dev1adesh/CapstoneGroup52/docs/FinalReport/MTE 481 - FDP (Actual).pdf

# MTE 481 -FINAL DESIGN

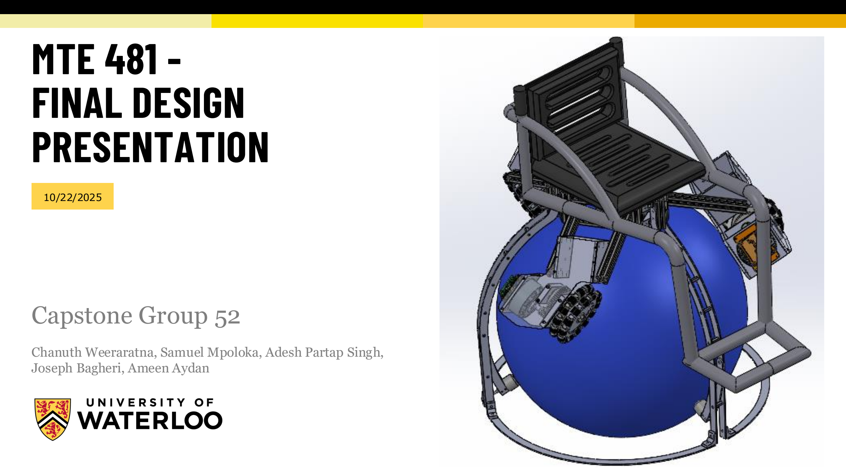
[picture p17: page 1]

# PRESENTATION

Photo credit: @bruce.digital

## Capstone Group 52

Chanuth Weeraratna, Samuel Mpoloka, Adesh Partap Singh, Joseph Bagheri, Ameen Aydan

10/22/2025

# REFRESH - NEEDS IDENTIFICATION

Factually:

- Wheelchair users engaged in day-to-day tasks are fundamentally limited by the need to use their hands for both propulsion and steering. → Hand accessibility
- “Building up through repetition” loads the shoulders in ways it was never optimized to bear over years. ( (https://pmc.ncbi.nlm.nih.gov/articles/PMC7364791/?utm_source=chatgpt.com)Barry Mason, (https://pmc.ncbi.nlm.nih.gov/articles/PMC7364791) 2020) (https://pmc.ncbi.nlm.nih.gov/articles/PMC7364791/?utm_source=chatgpt.com) → Prevalence of injury
- Those playing sports more than 1×/week had 75.7% occurrence of rotator cuff tears, vs. 36.3% in non-sport users. (Michael Akbar, 2015) (https://pmc.ncbi.nlm.nih.gov/articles/PMC5697842/) → Major barrier to participation

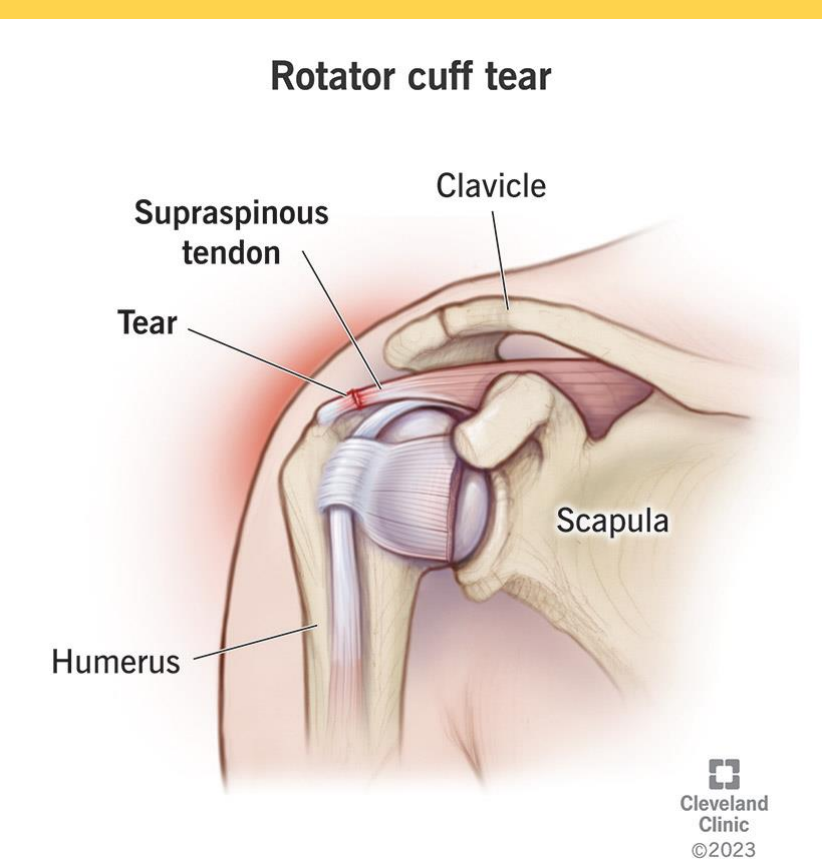
[picture p18: figure]

MTE 481 - FINAL DESIGN PRESENTATION | PAGE 2

Anecdotally:

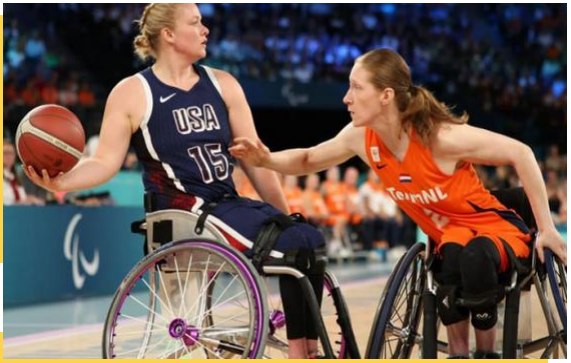
[picture p19: figure]

- Adrit Batra from Laurier enjoys street hockey as a hobby but finds that his arms frequently fatigue and the difficulty of single handed manipulation creates a steep learning curve.
- UWaterloo baseball operations coordinator Brody Daigneau finds that physical limitations not only affect performance, but also discourage play with non-impaired individuals, widening the inclusion gap.

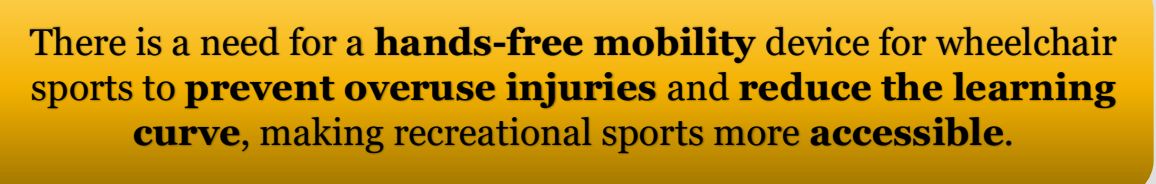
[picture p20: figure]

## There is a need for a hands-free mobility device for wheelchair sports to prevent overuse injuries and reduce the learning

curve, making recreational sports more accessible.

# NEEDS STATEMENT

# PROBLEM DEFINITION

- Hands-free propelling and steering while handling objects during gameplay.
- Working with the CAPACITY initiative to bring this hands-free wheelchair to PAC where it can be used for drop-in gameplay on campus.
- Focused on use in basketball to limit variables in design.
Object of Interaction | Environment
- Standard basketball • 50th to 90th percentile anthropometric human | • Basketball court • Flat, level, smooth surface • Good friction coefficient

Vague, non-measurable requirements

- Operation is simple and intuitive
- Including user control sensitivity adjustment
- Wheelchair is safe for the user and those around them
- Failsafe measures
- Speed limiter
- Passive and/or active protection from collisions
- Emergency stop

# USER REQUIREMENTS

- Human-machine interface doesn’t require input from the hands or arms
- Operation doesn’t interfere with gameplay
- E.g. the user takes their eyes off the ball
- Control accounts for a varying range of disabilities
- Cannot accommodate limited trunk control (class 1.0 -2.0 level disability).

# Engineering Requirements – Criteria Table

# | Criterion | Constraint | Objective

1 | Weight Capacity | 80kg | 110kg
2 | Footprint Radius | 60cm | 40cm
3 | Max Linear Speed (in all directions) | 2.3 m/s | 4.5 m/s
3 | Max Linear Acceleration (in all directions) | m 0.7 2 s | m 1.3 2 s
4 | Turning Time | - | 180 degrees in 1 sec
5 | Seat Height (Footrest to seat) | 50 ± 10cm | -
6 | Total Operating Time | 12mins | 40mins

# Critical Geometry

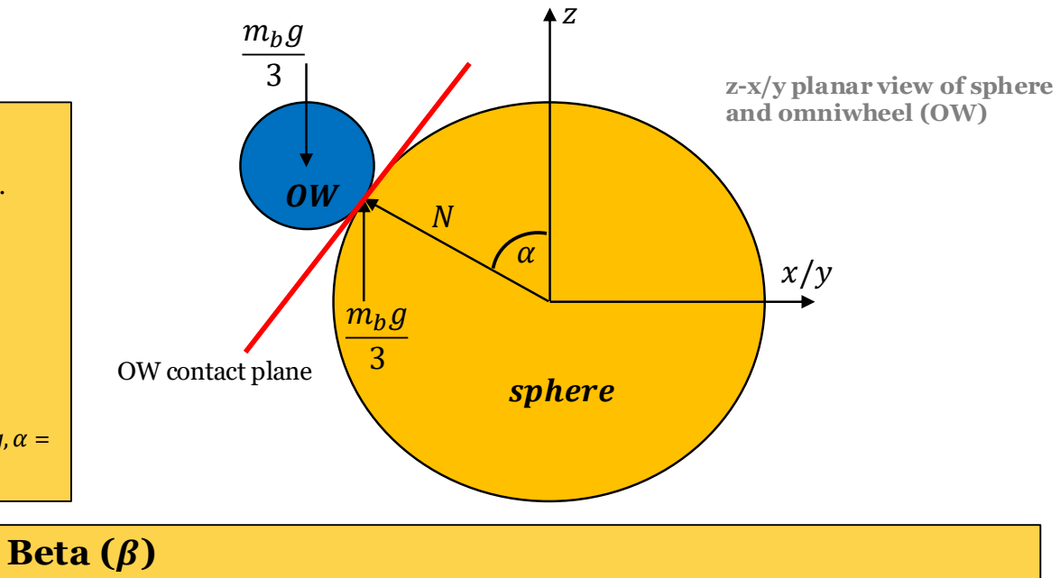
[picture p21: figure]
Beta (β); mbg 3; sphere; z-x/y planar view of sphere and omniwheel (OW); OW contact plane
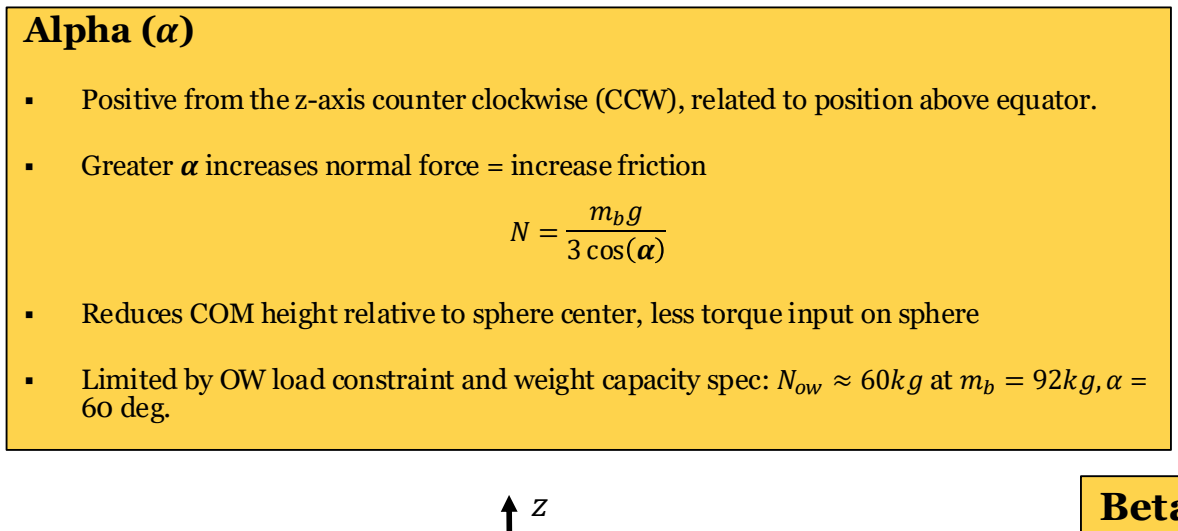
[picture p22: figure]
Alpha (α); mbg 3 cos α; 60 deg.

- Positive from the z-axis counter clockwise (CCW), related to position above equator.
- Greater α increases normal force = increase friction
- Reduces COM height relative to sphere center, less torque input on sphere
- Limited by OW load constraint and weight capacity spec: Now ≈ 60kg at mb = 92kg, α =

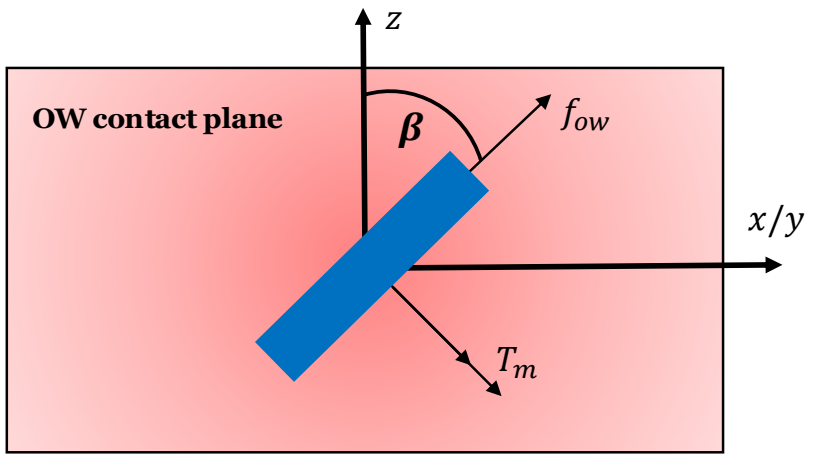
[picture p23: figure]
fow; OW contact plane

- β = 0° gives best x-y translation (resultant sits in friction cone), but can’t rotate platform body.
- At α = 60° → β ≈ 42° so OW are in mutually orthogonal planes. Most efficient orientation because no backdriving
- Set β = 30° to satisfy turning time (Tz
) and translation spec
(Tx, Ty) while maximizing efficiency.

# Transmission Specifications

Wheel Torque and Speed Modelling

- Wheeled inverse pendulum model taken in the z-x and z-y planes, linearized about sphere centre (θb ≥ 15 °).
- Ode45() function MATLAB to find inverse dynamics with eqn (1) and (2) (desired motion → torque at sphere centre along certain plane)
- Sphere acceleration, velocity and direction mapped to torque, angular velocity components in sphere centre, mapped to torque and speed requirements at wheel, eqn
(3) and (4). Note: Tw is transposed for wheel speed conversion matrix.
- Turning time is simple torque about z, Tz and inertia of body about z (relatively low requirements, beta didn’t need to be extreme)
| Ts Mxሷ+ mblθሷ= (1) rs

2 θሷ− mblxሷ= Ts(2) mbglθ − Ib + mbl

Motor Spec

- Max wheel torque and speed extracted for linear acceleration, linear velocity and turning speed specs.
- Cont. and within linear T-w region → 1:4 speed red.
| Speed (rad/s) | Torque(N. m.)
OW requirement | 55 | 13
M8325s 100KV | 218 | 3.3

z-axis

x/y-axis

# Mechanical Design

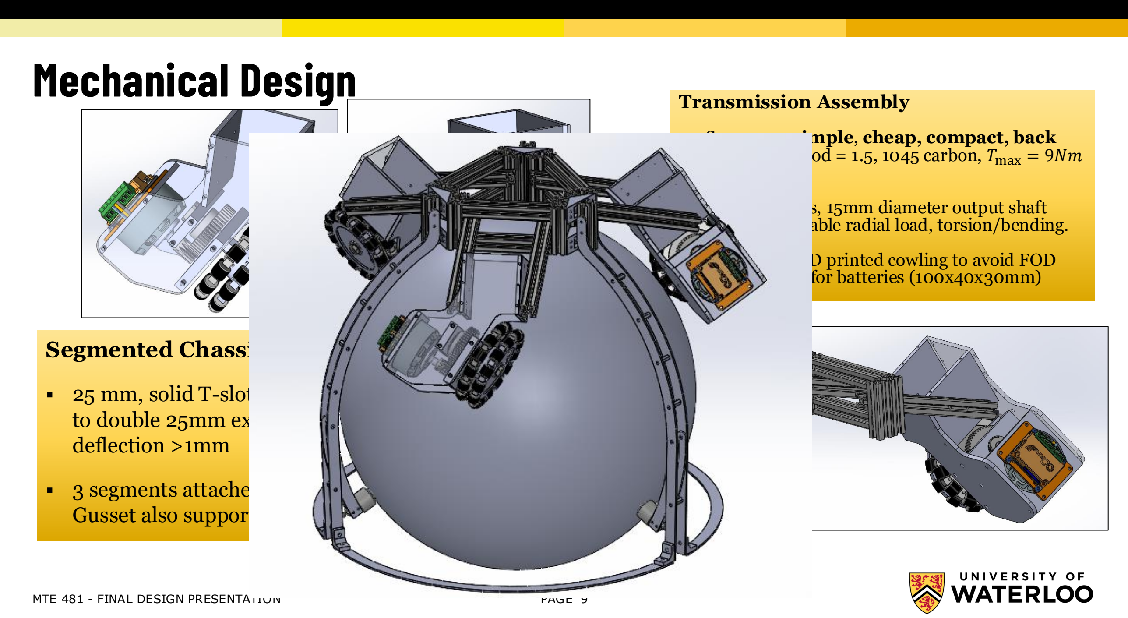
[picture p24: page 9]

Transmission Assembly

- Spur gears simple, cheap, compact, back drivable. (mod = 1.5, 1045 carbon, Tmax = 9Nm at pinion)
- 6202 bearings, 15mm diameter output shaft within acceptable radial load, torsion/bending.
- Sealed with 3D printed cowling to avoid FOD and add area for batteries (100x40x30mm)

Segmented Chassis

- 25 mm, solid T-slot extrusion cantilever to double 25mm extrusion. Expected deflection >1mm
- 3 segments attached via thick AL gusset. Gusset also support safety hardware.

# Mechanical Design

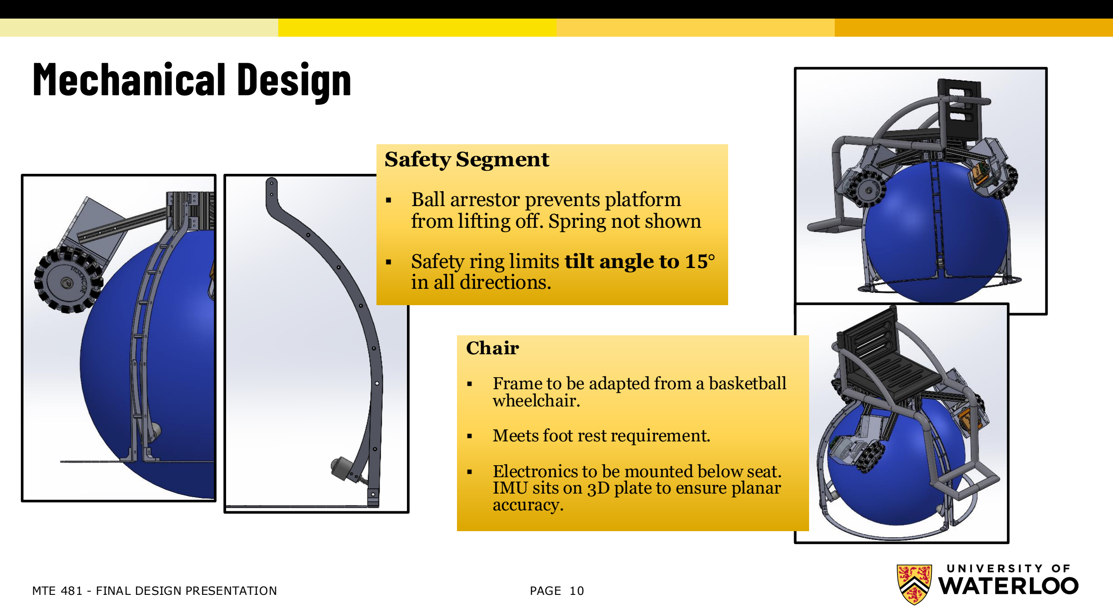
[picture p25: page 10]

Chair

- Frame to be adapted from a basketball wheelchair.
- Meets foot rest requirement.
- Electronics to be mounted below seat. IMU sits on 3D plate to ensure planar accuracy.

Safety Segment

- Ball arrestor prevents platform from lifting off. Spring not shown
- Safety ring limits tilt angle to 15° in all directions.

# Mechanical Design

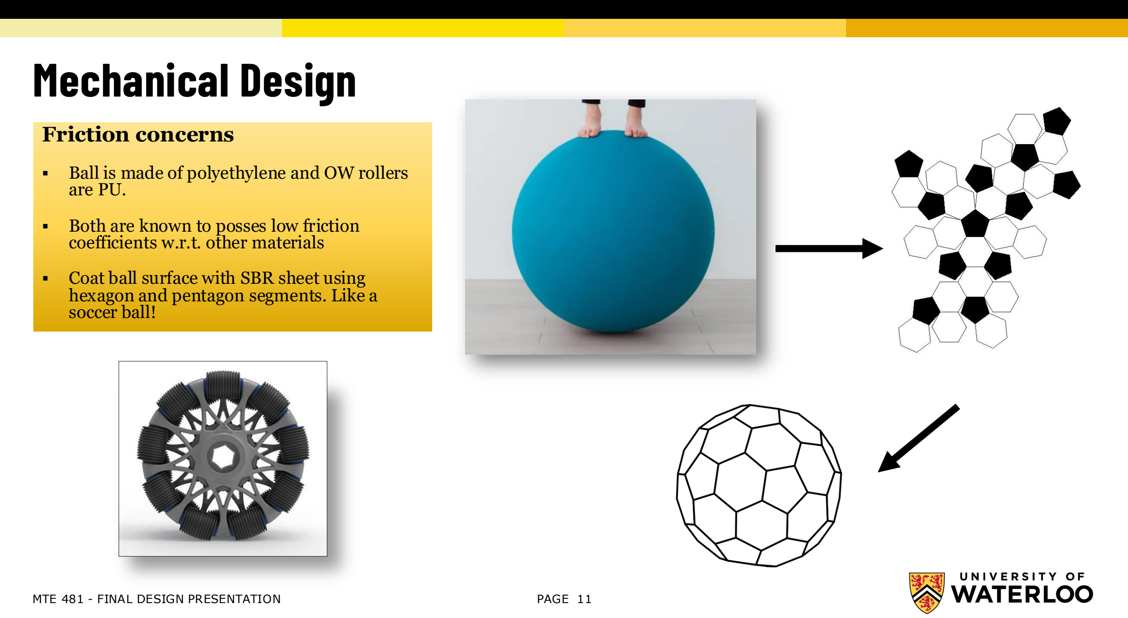
[picture p26: page 11]

Friction concerns

- Ball is made of polyethylene and OW rollers are PU.
- Both are known to posses low friction coefficients w.r.t. other materials
- Coat ball surface with SBR sheet using hexagon and pentagon segments. Like a soccer ball!

# Electrical System

Subsystem | Parts Included | Function
Power System | Batteries, Fuses, Relays, Volt/Ammeter, E-Stop | High-current power + safety
Motor Control | ODrive S1, M8325 Motors, Encoders | High-current power + safety
CAN Network | Transceiver, Bus Wiring, Termination | Communication backbone
MCU | Teensy 4.1 + Power | Central controller for LQR + system logic
IMU | BNO086 Sensors | User-lean + state estimation

# High-Level Block Diagram

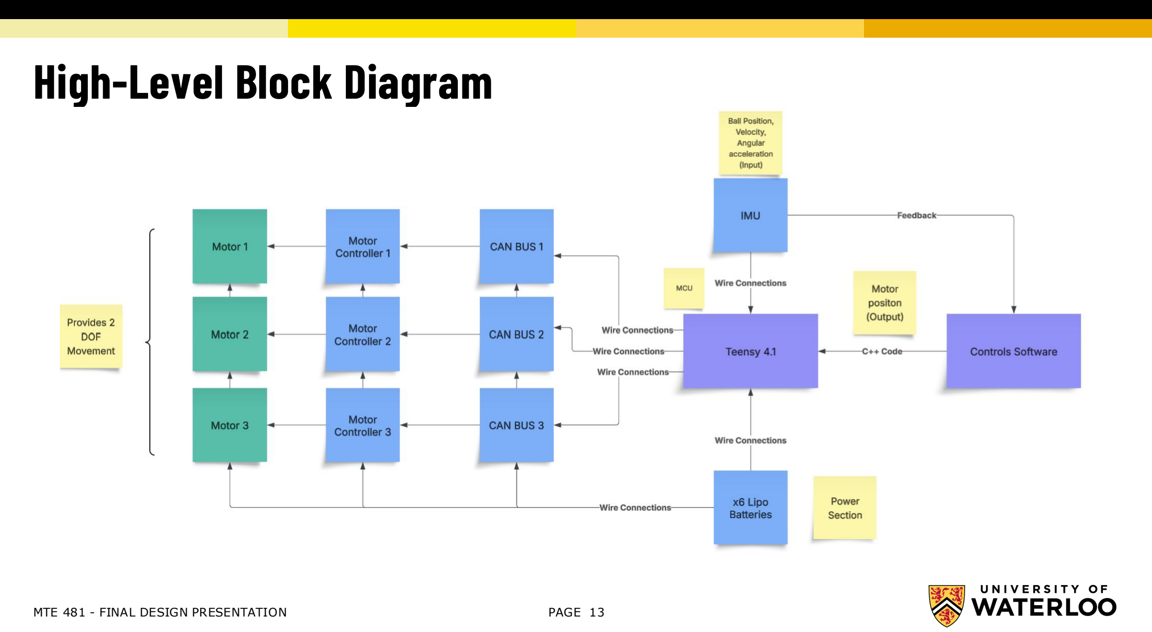
[picture p27: page 13]

# System Architecture

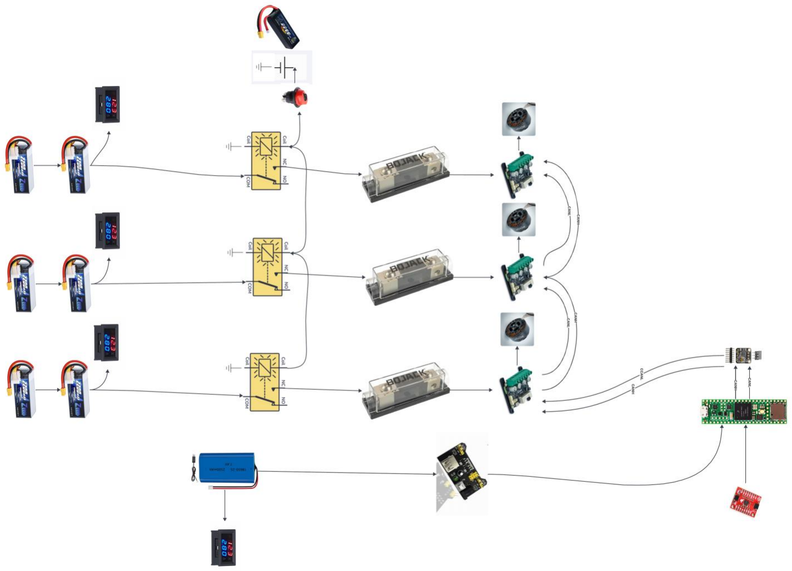
[picture p28: figure]

Electrical System Design Choices

- LiPo batteries arranged in 2-in-series pairs
- Safety System: Relay, Precharge circuitry, fuses, Estop
- Sensor Redundancy

# Operating Time

Given:

- Kt = 0.083 Nm
A
- τmax = 3.3 Nm
- ωmax = 2A = 2π × 30 = 188.5

rad
s
- Rpℎase = 0.024 Ω
- ηmotor = 85 %
- Vbatt pack44.4V
- C = 2.2 Aℎ

I =

τmax
Kt

= 39.8 A ≅ 40 A

Pmecℎ = τmax × ωmax = 622 W

## Pcu = I

## 2 × R = 40² × 0.024 = 38 W

Ptotal = Pmecℎ + Pcu = 660 W ηmotor = Ptotal/Pin
Pin= Ptotal /ηmotor=660/0.85=776 W

Vbatt pack = 44.4V

## C = 2.2 Aℎ E = Vbatt pack × C = 44.4 × 2.2 = 98 Wℎ

## t = E/ Pin = 98/776 = 0.126 h

## t =0.126 × 60 = 7.56 mins

Power Calculations

Operating Time

# Wiring

- Logic Power: The Teensy microcontroller supplies 3.3V and GND to power the CAN transceiver module.

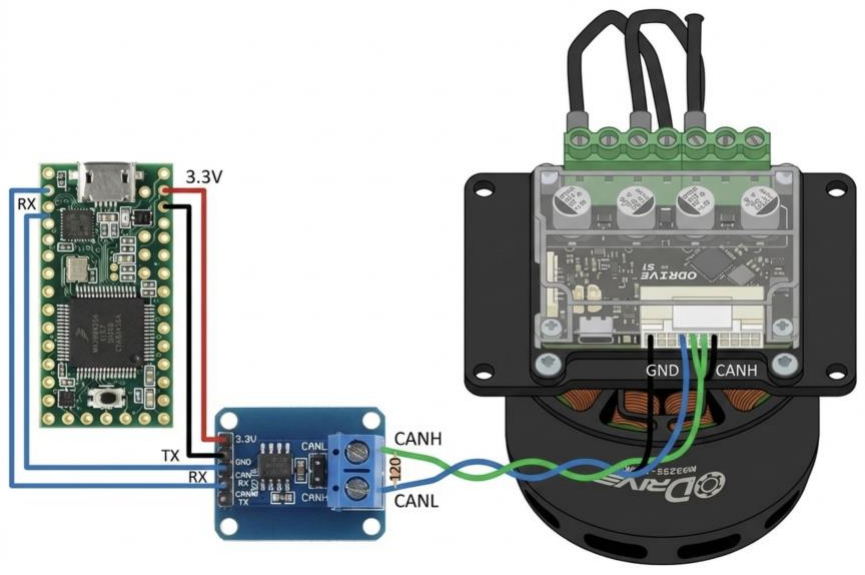
[picture p29: figure]

- Signal Interface: Teensy TX/RX pins transmit single-ended UART commands to the transceiver chip.
- Protocol Conversion: The transceiver converts these logic signals into Differential CAN (CAN High & CAN Low) for robust data transmission.
- Controller Input: The differential CAN lines connect directly to the ODrive S1's dedicated communication port.
- Hardware Integration: The ODrive S1 is mounted directly to the motor backplate, eliminating the need for external phase wiring.

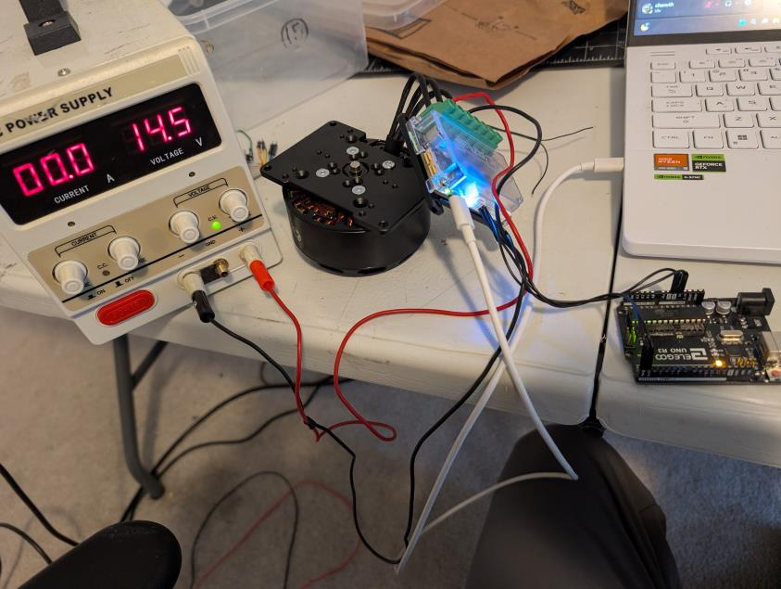
[picture p30: figure]

# Testing

- Hardware Integration: Successfully integrated the M8325 Brushless DC motor with the ODrive Pro motor controller for high-precision actuation.
- Communication Protocol: Established a UART serial interface between the Arduino microcontroller and ODrive for real-time command transmission.
- Configuration: Calibrated motor parameters (current limits and velocity gains) using the ODrive GUI prior to embedded deployment.

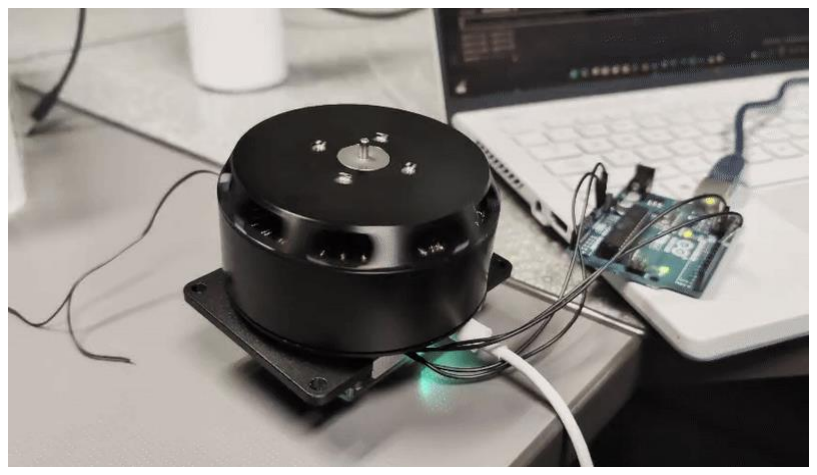
[picture p31: figure]

- Power Verification: Validated system performance under load using a 14.5V lab bench power supply configuration.
- Functional Testing: Confirmed successful motor states (Idle, Closed-Loop Control) and position targeting via Arduino commands.

# Next steps for Electrical setup

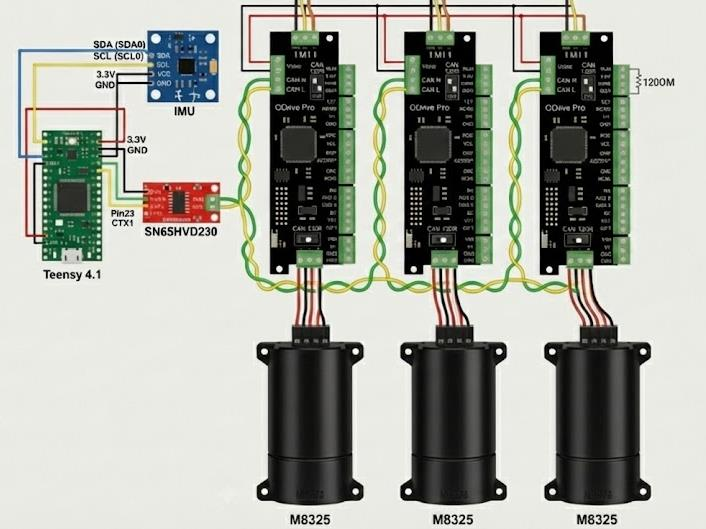
[picture p32: figure]

- Architecture Migration: Transition from UART to
CAN Bus communication to enable robust, high-speed daisy-chaining of three independent ODrive motor nodes.
- Processor Upgrade: Replace the Arduino with a Teensy 4.1 to leverage its native CAN support and higher processing speed for low-latency multi-axis coordination.
- State Estimation: Integrate a 6-DOF IMU (via I2C/SPI) to provide real-time orientation feedback and system state data to the main controller.
- Control Logic: Implement a closed-loop PID algorithm on the Teensy that maps IMU orientation error to counter-active torque commands for dynamic stabilization.
- System Scaling: Scale the electrical subsystem to support simultaneous current draw for all three M8325 motors while maintaining signal integrity.

# Controls Design

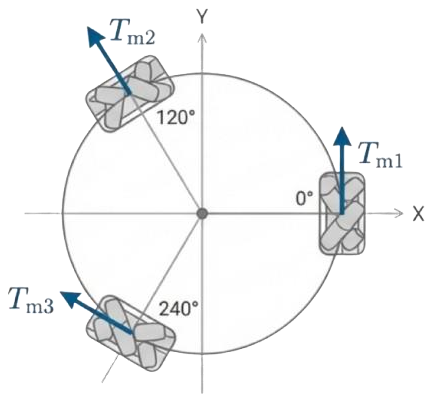
[picture p33: figure]

## Goal:

- Achieve intuitive, real-time control based on the user's lean, mirroring the seamless motion of а Segway.

## The Core Problem:

- Achieve intuitive, real-time control based on the user's lean, mirroring the seamless motion of а Segway.

# From Physics to Formulas: Modeling Our System Plant

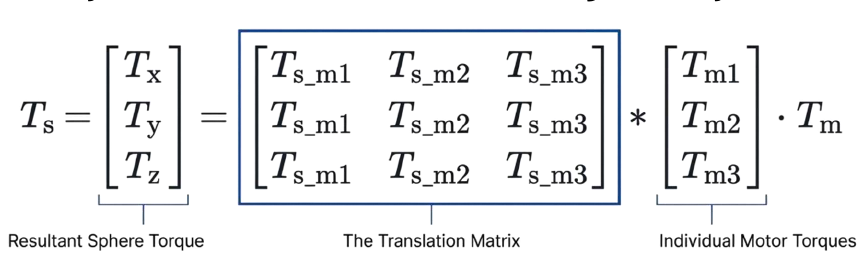
[picture p34: figure]

- This matrix translates individual motor torques into a net torque on the sphere, forming the core of our dynamic model.
- A precise model is essential for designing a controller that performs predictably.
- We translated the system's physics into a
state-space representation using
MATLAB.
Key Assumptions: - 100% motor efficiency. - No-slip contact between omni-wheels and sphere.

# State-Space Controller for Optimal Performance

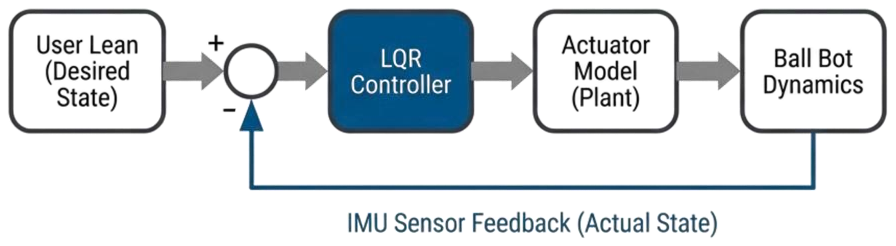
[picture p35: figure]

- Tunable Performance: Allows us to precisely tune the trade-off between aggressive responsiveness and smooth energy consumption.
- Guaranteed Stability: Provides a mathematically proven guarantee of stability for our linearized model.

Chosen Method: A Linear-Quadratic Regulator (LQR) state-space approach. Why LQR?

- Optimal for MIMO Systems: Ideally suited for managing multiple inputs (motor torques) and outputs (position, orientation).

Refine the Controller in a Realistic Virtual World.

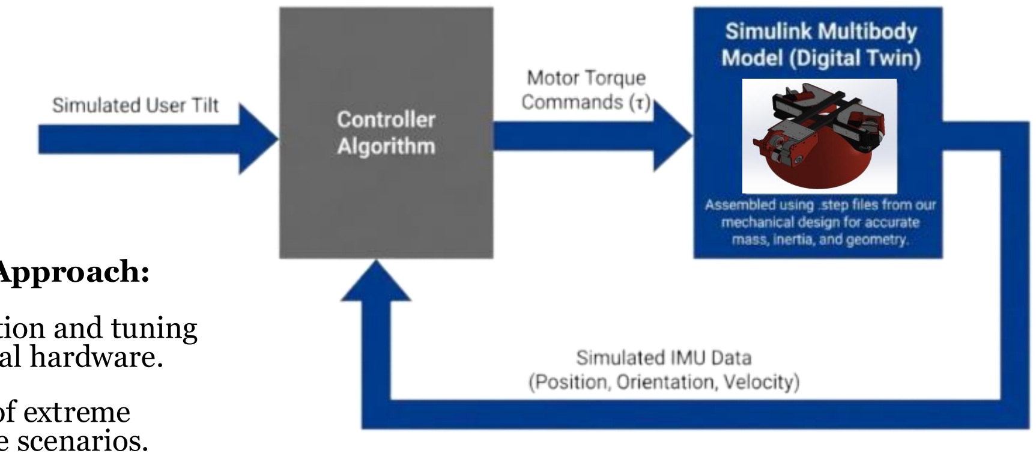
[picture p36: figure]

Key Benefits of This Approach:

- Allows for rapid iteration and tuning without risk to physical hardware.
- Enables safe testing of extreme maneuvers and failure scenarios.
- Ensures the controller is robust and reliable before physical deployment.
