dev1adesh/CapstoneGroup52/docs/FinalReport/MTE481 - Preliminary Design Presentation.pdf

# MTE 481 -PRELIMINARY DESIGN

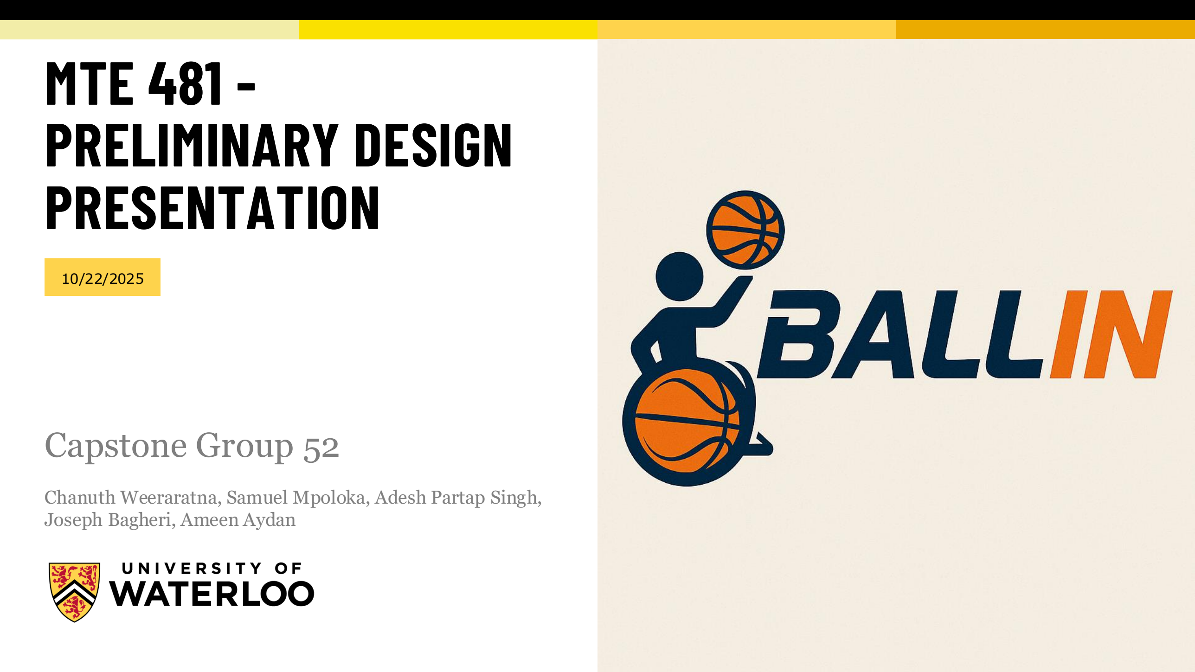
[picture p37: page 1]

# PRESENTATION

Photo credit: @bruce.digital

# Capstone Group 52

Chanuth Weeraratna, Samuel Mpoloka, Adesh Partap Singh, Joseph Bagheri, Ameen Aydan

10/22/2025

## I. Needs Identification

## II. Problem Definition

## III. Design Specification (Criterion, Constraints, Objectives)

## IV. Alternate Design Concepts

## V. Selection Matrix

## VI. Applicable Patent

## VII. Timeline (Gantt chart)

MTE 481 - PRELIMINARY DESIGN PRESENTATION | PAGE 2

# PRESENTATION CONTENT

# Hands Free Mobility

# NEEDS IDENTIFICATION

# NEEDS IDENTIFICATION

- Wheelchair users engaged in day-to-day tasks are fundamentally limited by the need to use their hands for both propulsion and steering.
- What activities could always be more enjoyable or easier with access to both hands?
- E.g. Holding your kids' hands, opening a door, carrying groceries, etc

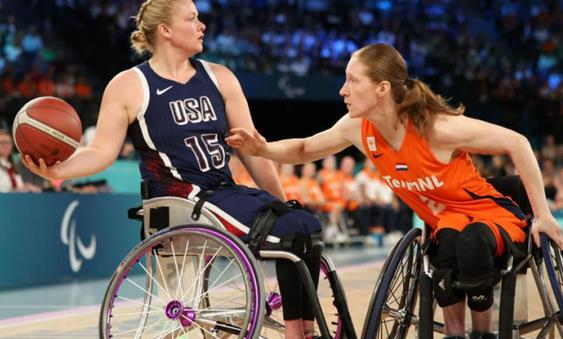
[picture p38: figure]

Anecdotally:

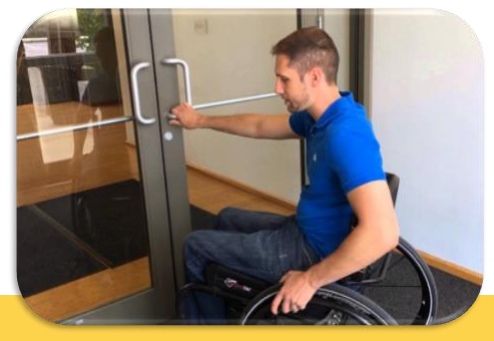
[picture p39: figure]

- Adrit Batra from Laurier enjoys street hockey as a hobby but finds that his arms frequently fatigue, and injury is common in wheelchair sports.
- The “building up through repetition” nature of propulsion places loads that the shoulder was never optimized to bear over years. ( (https://pmc.ncbi.nlm.nih.gov/articles/PMC7364791/?utm_source=chatgpt.com)Barry Mason, (https://pmc.ncbi.nlm.nih.gov/articles/PMC7364791) 2020) (https://pmc.ncbi.nlm.nih.gov/articles/PMC7364791/?utm_source=chatgpt.com)
- Constant switching between tasks also creates a steeper learning curve for many wheelchair sports, which was a deterrent for Adrit Batra before he took up the hobby.

# The Hidden Cost

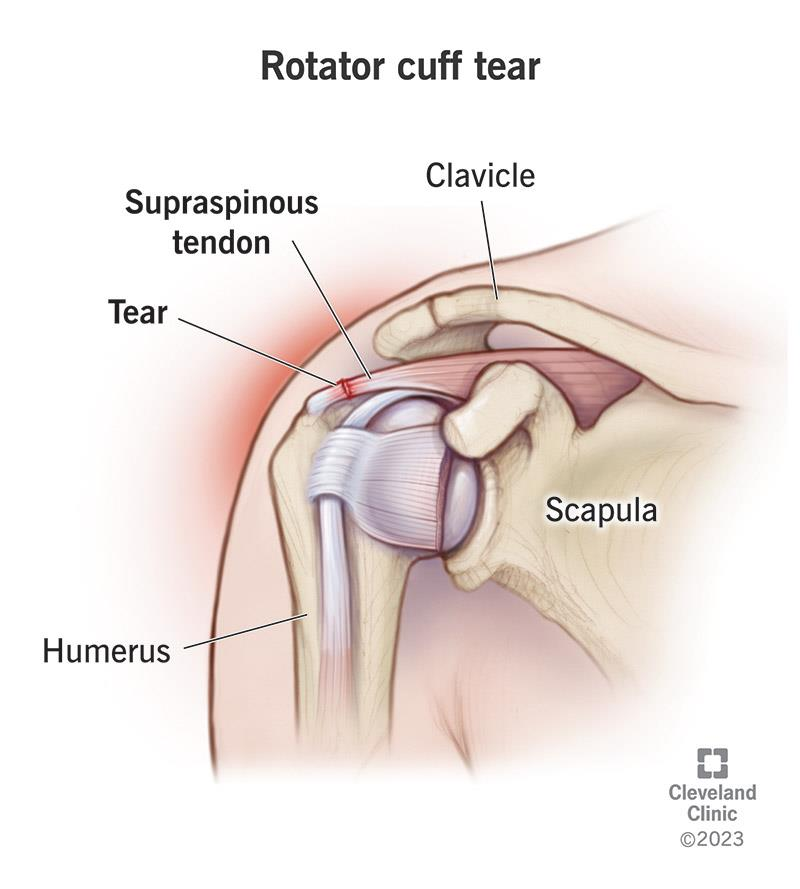
[picture p40: figure]

### - A systematic review found that shoulder pain is the most frequent musculoskeletal complaint in

wheelchair users, driven largely by overuse,

### tendinopathy, and rotator cuff tears (Shawn Song, 2022). (https://now.aapmr.org/shoulder-problems-pain-in-the-wheelchair-athlete)

### - Among wheelchair athletes, shoulder complaints are extremely common — reported prevalence ranges from 16% up to 76% across studies. (Omar W Heyward, 2017) (https://pmc.ncbi.nlm.nih.gov/articles/PMC5697842/)

### - In a study of 296 full-time manual wheelchair users, those playing sports more than 1– 2×/week had 75.7% occurrence of rotator cuff tears, vs. 36.3% in non-sport users. (Michael Akbar, 2015)

# NEEDS IDENTIFICATION

# Hands-free wheelchair for sports could open another avenue of enjoyment and reduce the rates of injury for wheelchair users engaged in hockey, basketball, or

tennis, among other sports.

# NEEDS STATEMENT

# PROBLEM DEFINITION

# PROBLEM DEFINITION

## - Wheelchair users who are frequently engaged with sports must

use their arms to propel, steer and handle the ball.

## - The intensity and frequency of these movements leave the

conventional wheelchair user vulnerable to injuries.

## - The wheelchair also constrains the user's agility and natural gameplay, creating a larger learning curve and a reluctance to

take up the sport.

# PROBLEM DEFINITION

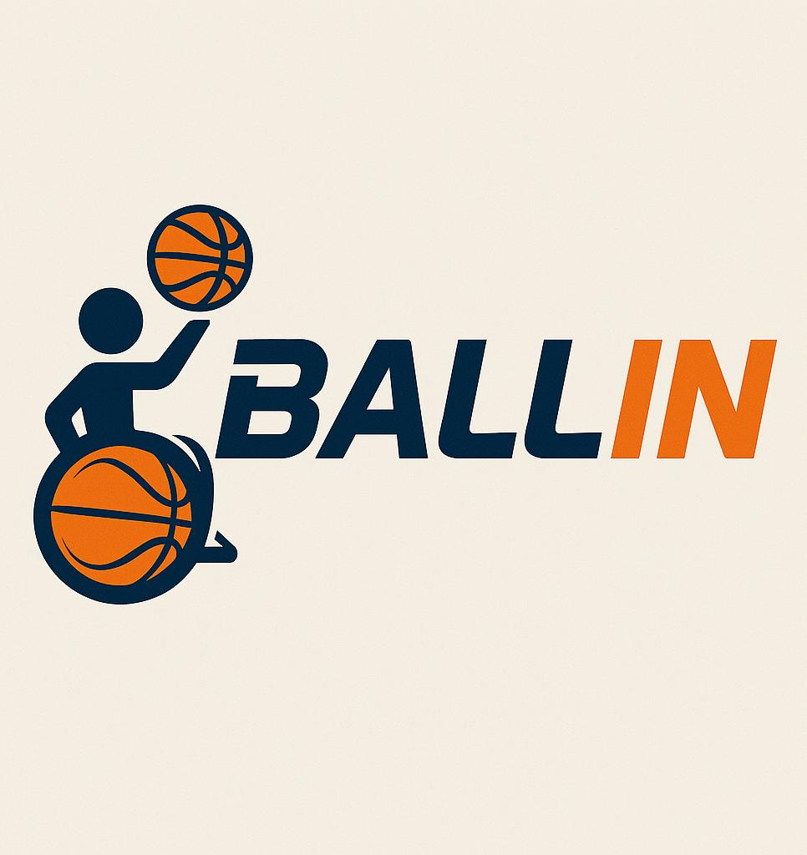
[picture p41: figure]

## Will focus on basketball as the environment and objects of interaction are easy to define and much narrower in focus

Vague, non-measurable requirements tied to the user and count towards the selection matrix

- Operation should be simple and intuitive
- Including user control sensitivity adjustment
- Wheelchair should be safe for the user to operate and those around them
- Failsafe measures
- Speed limiter
- Passive and/or active protection from collisions
- Emergency stop

# USER REQUIREMENTS

### - Human-machine interface doesn’t require input from the hands or arms

### - Method of operation should not interfere with gameplay

- E.g. the user takes their eyes off the ball

### - Mimic the full range of motion of an able-bodied player: 2 degrees of translation and 1 degree of rotation

- ‘mimic natural gameplay” problem def’n

### - Control method should account for a varying range of disabilities

# Criterion #1

## - Weight capacity should accommodate 50th to 95th

percentile man (Weight Percentile Calculator) (https://dqydj.com/weight-percentile-calculator-men-women/?utm_source=chatgpt.com)

# Engineering Requirements

50th – percentile weight | Approx 80kg
95th –percentile weight | Approx 110kg

# Engineering Requirements

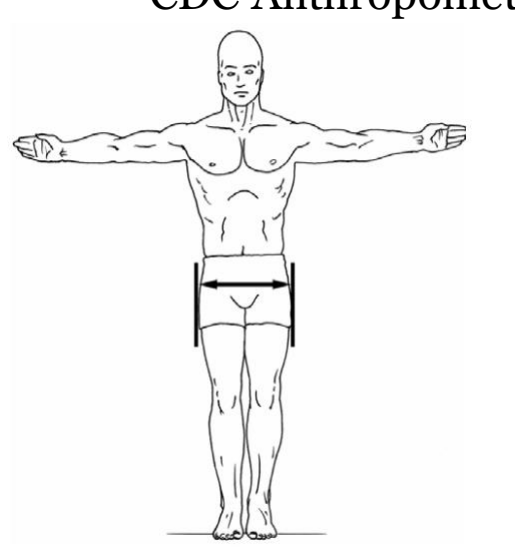
[picture p42: figure]
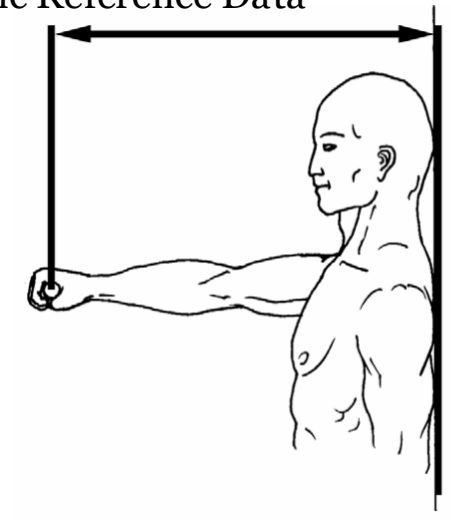
[picture p43: figure]

# Criterion #2

- The wheelchair itself must not get in the way when handling game objects (e.g. basketballs, hockey stick)
- Justified as the length outside a cross section to touch a ball
- 90th – percentile hip breadth is 36.82 cm - Objective

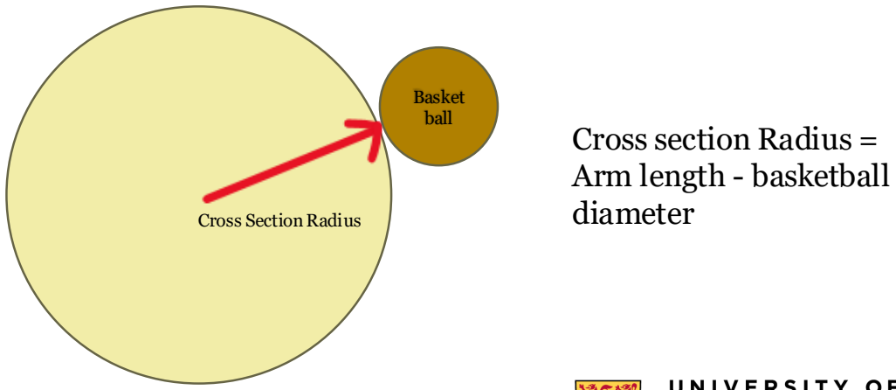
[picture p44: figure]
ball; Cross section Radius = Arm length - basketball; Cross Section Radius; diameter

- | 50th – percentile grip reach is 74.95 cm - Constraint | Basket

### CDC Anthropometric Reference Data

# Engineering Requirements

# Criterion #3

- More aggressive performance specifications are better for use in a basketball sports
- Metrics shown are meant for all directions of travel
- Justified in the following studies
- (https://pubmed.ncbi.nlm.nih.gov/1532225/) Dynamics of wheelchair basketball (https://pubmed.ncbi.nlm.nih.gov/1532225/) (K D Coutts, 1992)
- (https://pubmed.ncbi.nlm.nih.gov/7965870/) Drag and sprint performance of wheelchair basketball players (https://pubmed.ncbi.nlm.nih.gov/7965870/) (K D Coutts, 1992)
- (https://arxiv.org/pdf/2304.02887) Low profile, omni (https://arxiv.org/pdf/2304.02887)- (https://arxiv.org/pdf/2304.02887)directional stool (https://arxiv.org/pdf/2304.02887)
- What has already been achieved
Criterion | Constraint | Objective
Max Speed | 2.3 m/s | 4.75 m/s
Acceleration | 0.7 m/s/s | 1.3 m/s/s
Angular velocity | Implied in above criteria

### Stopping distance

# Engineering Requirements

# Criterion #4

## - Seat height should be the same as that of a

standard wheelchair.

## - Must rest feet, transfer user, etc

## - Standard seat height: approx. 50cm

### - ±10cm to allow for design variation

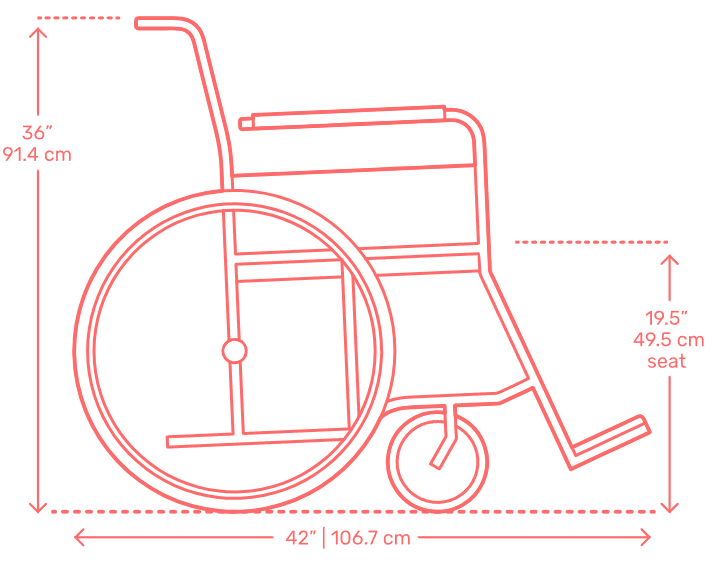
[picture p45: figure]

Dimensions of a standard wheelchair (Fisher, 2024) (https://www.dimensions.com/element/wheelchairs)

# Engineering Requirements

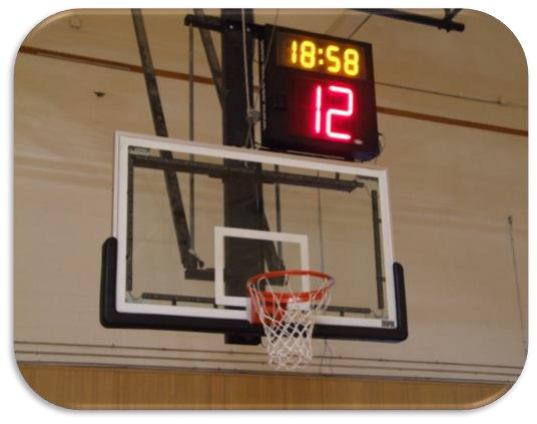
[picture p46: figure]

# Criterion #5

## - Operating time should aim for the duration of a full game of basketball (40 mins)

## - This metric will have a minimum of 12

## mins per basketball game quarter

# Engineering Requirements – Criteria Table

# | Criterion | Constraint | Objective

1 | Weight Capacity | 80kg | 110kg
2 | Footprint Radius | 60cm | 40cm
3 | Max Linear Speed (in all directions) | 2.3 m/s | 4.5 m/s
3 | Max Linear Acceleration (in all directions) | m 0.7 2 s | m 1.3 2 s
4 | Max Angular Speed | 180 degrees/s | -
5 | Seat Height (Footrest to seat) | 50 ± 10cm | -
6 | Total Operating Time | 12mins | 40mins
