dev1adesh/CapstoneGroup52/docs/Final Design Presentation/Block Diagrams/High Level Block Diagram.png

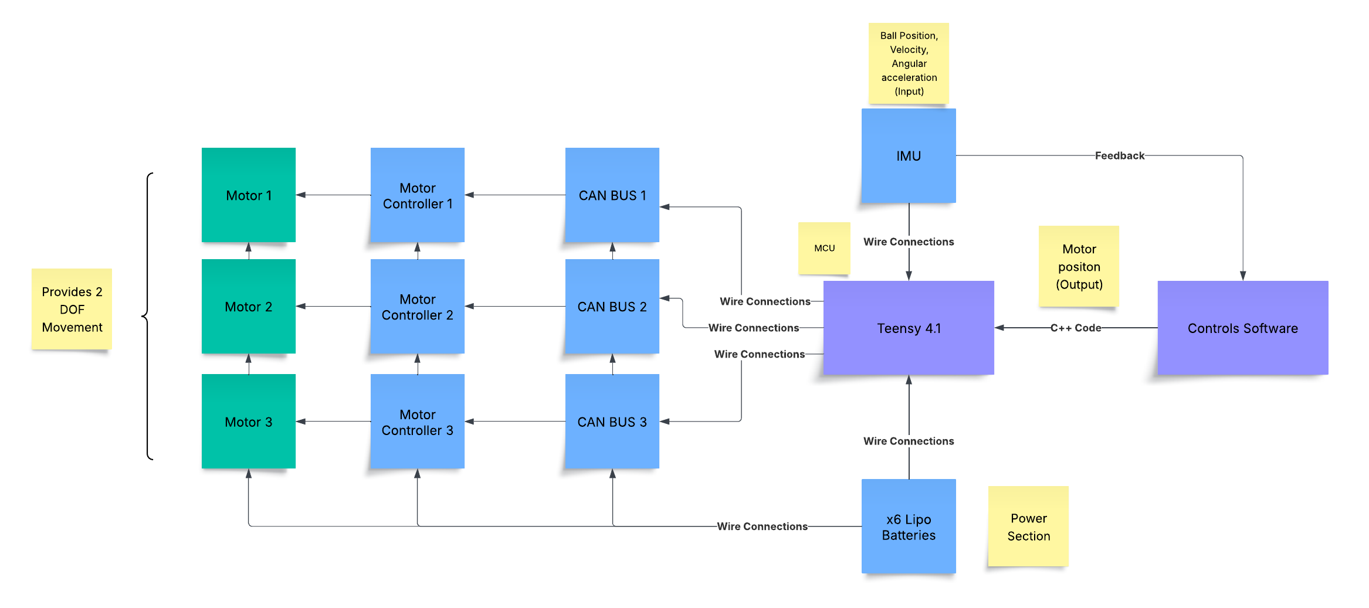
docs/Final Design Presentation/Block Diagrams/High Level Block Diagram.png
