dev1adesh/CapstoneGroup52/docs/FinalReport/US7847504B2_Patent3.png

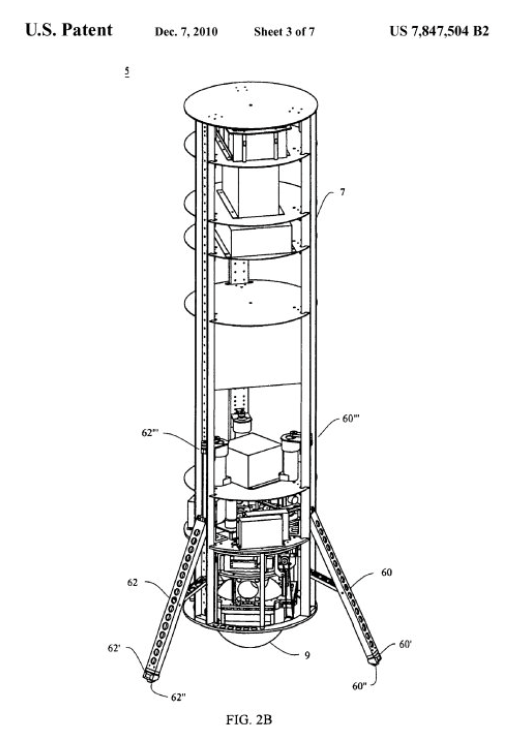
docs/FinalReport/US7847504B2_Patent3.png
