dev1adesh/CapstoneGroup52/docs/Final Design Presentation/Block Diagrams/Component Block Diagram.png

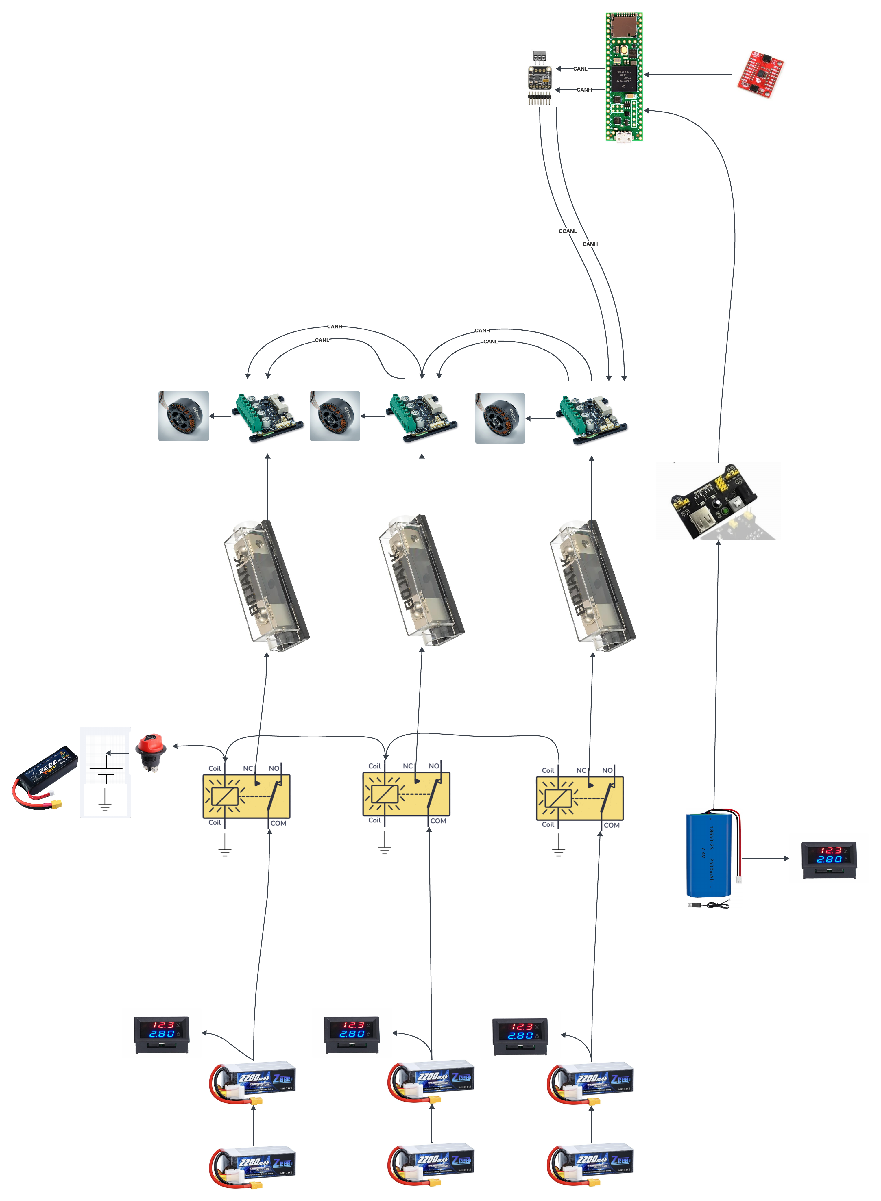
docs/Final Design Presentation/Block Diagrams/Component Block Diagram.png
