dev1adesh/CapstoneGroup52/(commit log)

2025-11-08 Documentation Added
    Capacity Documentation Added
    Reorganization of pdp files
2025-11-13 Parts List
    Estop and relay added
2026-03-12 Add controlCode: modular LQR ball-balance firmware (Teensy, dual IMU, ODrive)
    Made-with: Cursor
2026-03-12 Platform/ref swap flag (PLATFORM_USE_IMU_B), IMU B 6-state and gyro cal
    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
    [arduinoCode.ino]
